arthurfreitas96/PFCII/LFS/Photos/Componentes Removidos da Planta.jpeg

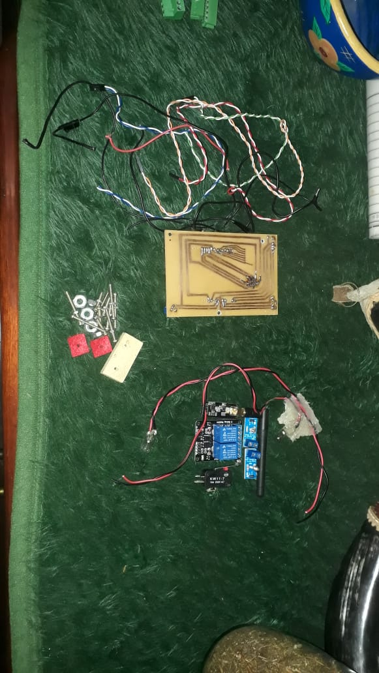
LFS/Photos/Componentes Removidos da Planta.jpeg
