arthurfreitas96/PFCII/LFS/Circuits/HV_Circuit.png

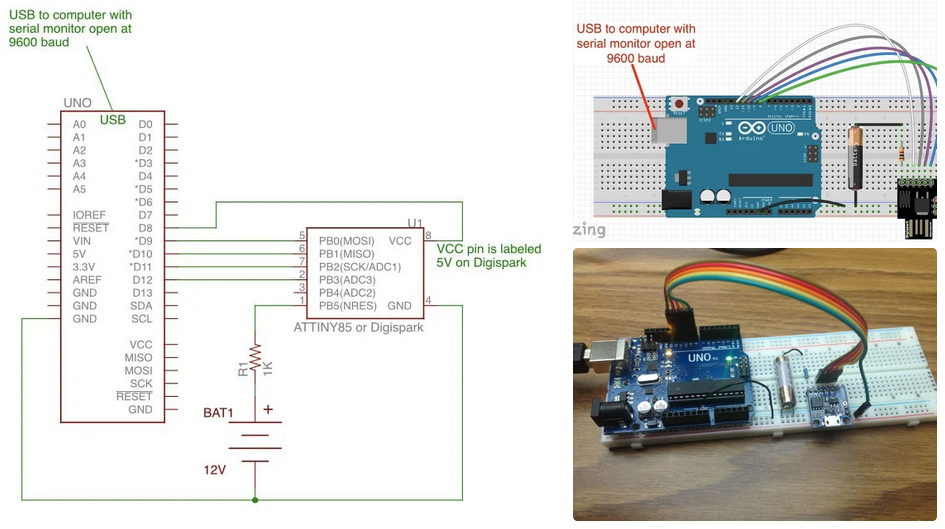
LFS/Circuits/HV_Circuit.png
