arthurfreitas96/PFCII/LFS/Solar_Charts_BH/Carta UofO Hor Padrao.pdf

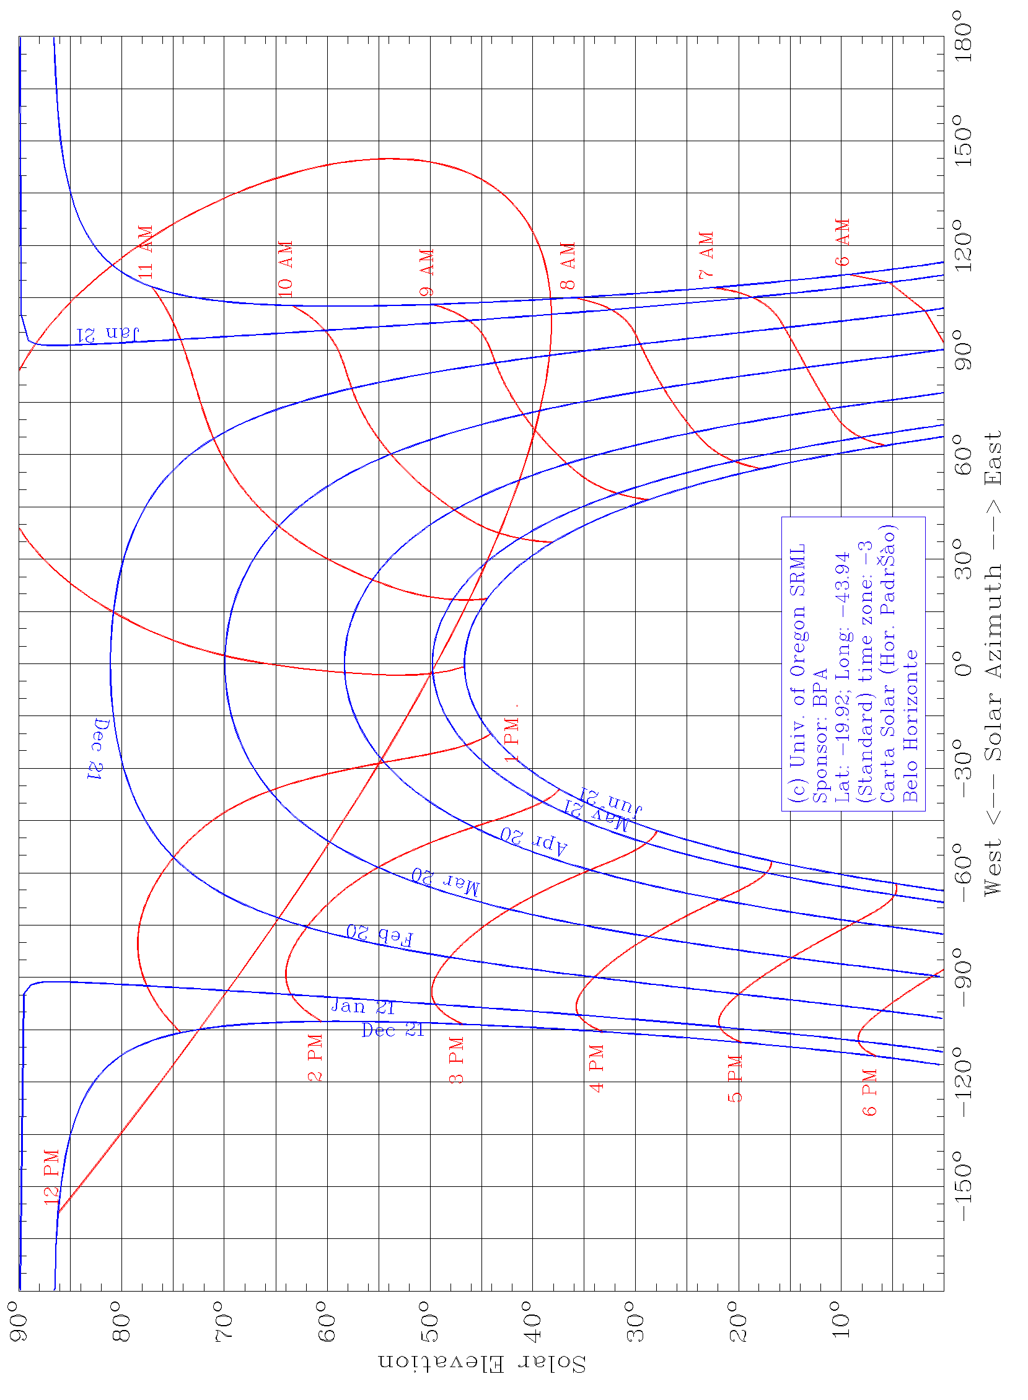
[picture p17: page 1]
