arthurfreitas96/PFCII/LFS/Solar_Charts_BH/Carta UofO.pdf

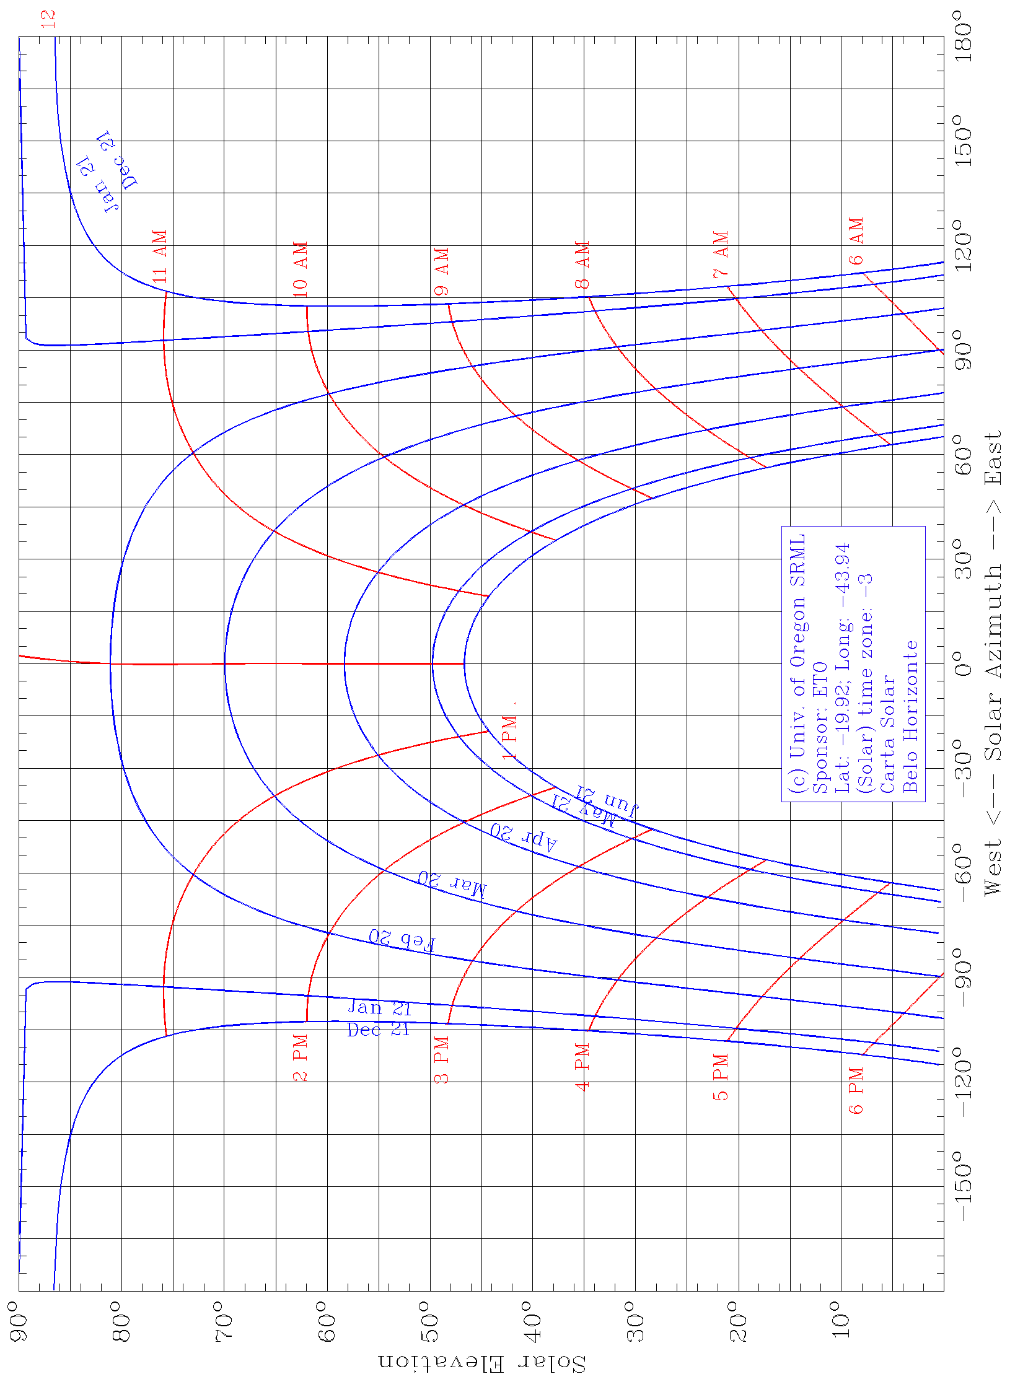
[picture p18: page 1]
