arthurfreitas96/PFCII/LFS/Circuits/Circuito Piranometro_I2C_PB5_IO.png

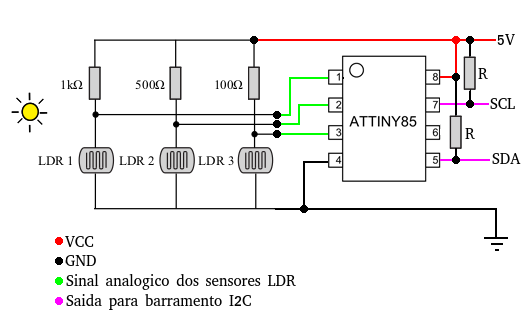
LFS/Circuits/Circuito Piranometro_I2C_PB5_IO.png
