arthurfreitas96/PFCII/LFS/Circuits/CircuitoPotencia.png

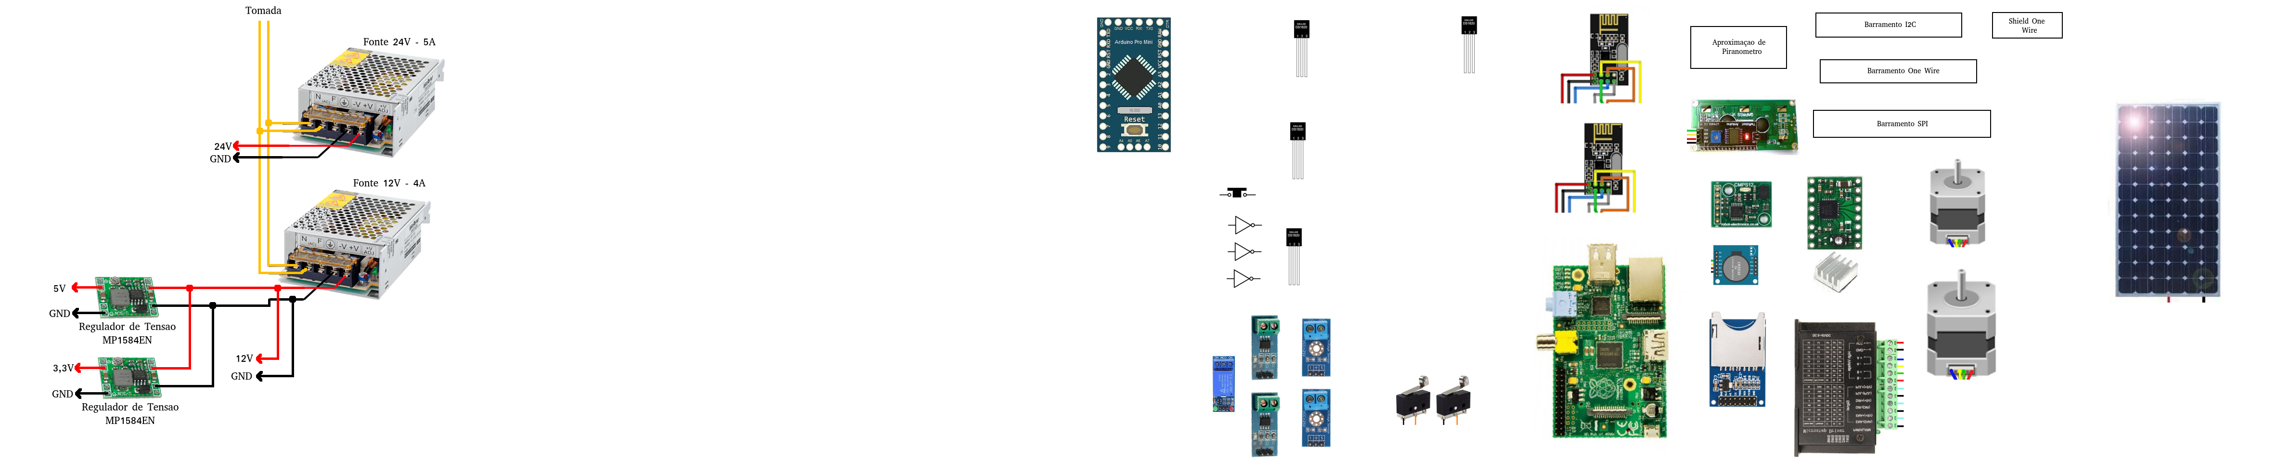
LFS/Circuits/CircuitoPotencia.png
