arthurfreitas96/PFCII/LFS/Circuits/GeracaoEConsumo.png

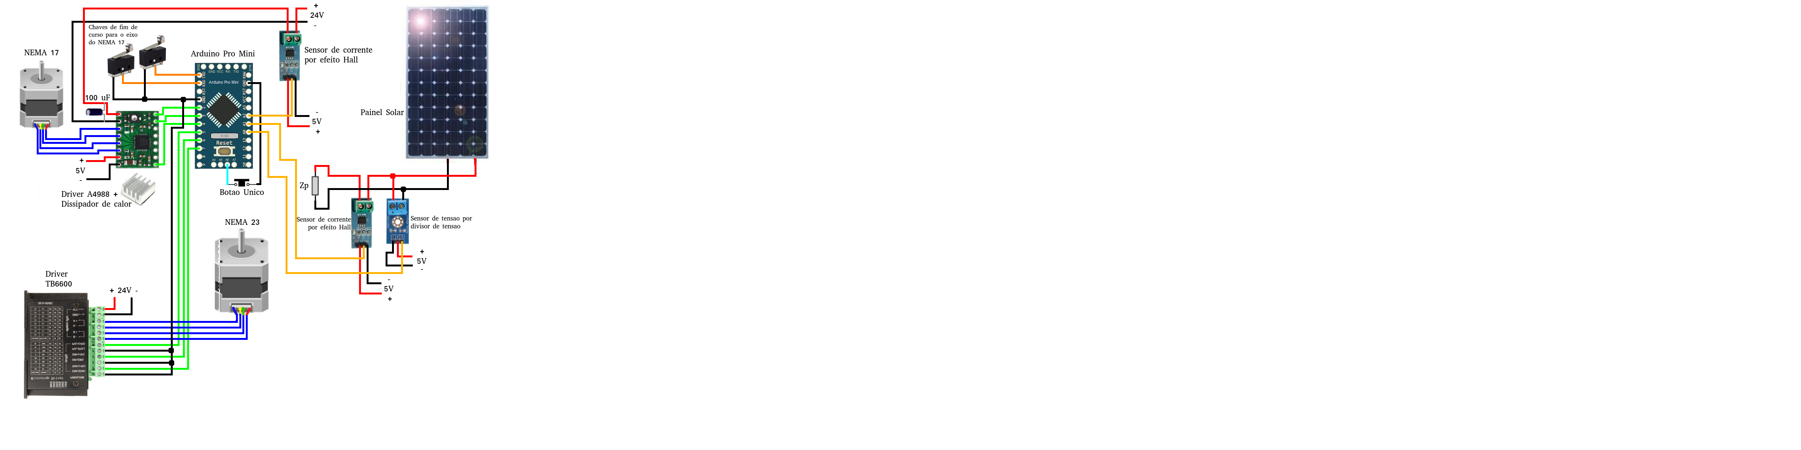
LFS/Circuits/GeracaoEConsumo.png
