arthurfreitas96/PFCII/LFS/Circuits/I2C.png

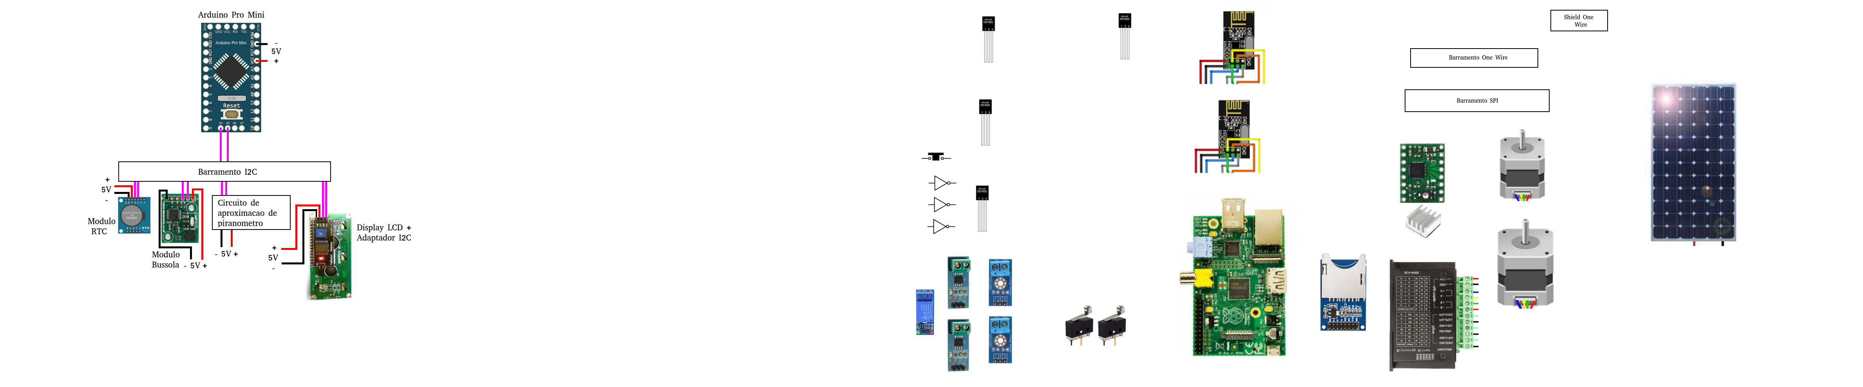
LFS/Circuits/I2C.png
