arthurfreitas96/PFCII/LFS/Circuits/OneWire.png

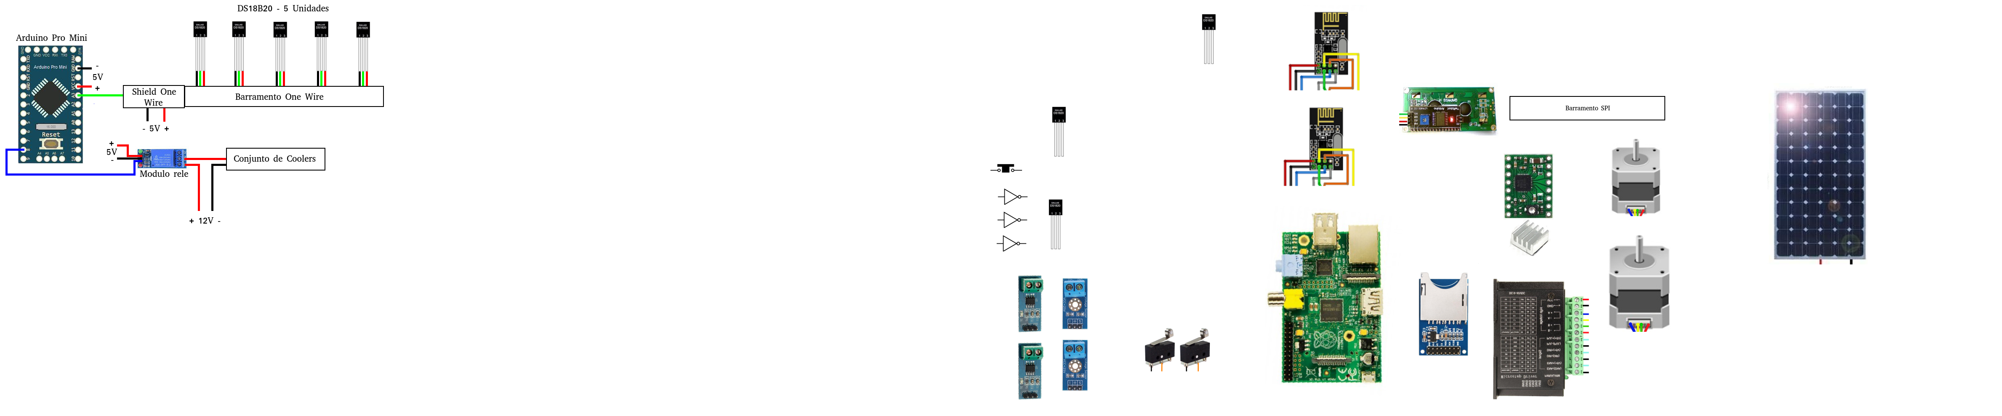
LFS/Circuits/OneWire.png
