arthurfreitas96/PFCII/LFS/Circuits/SPI.png

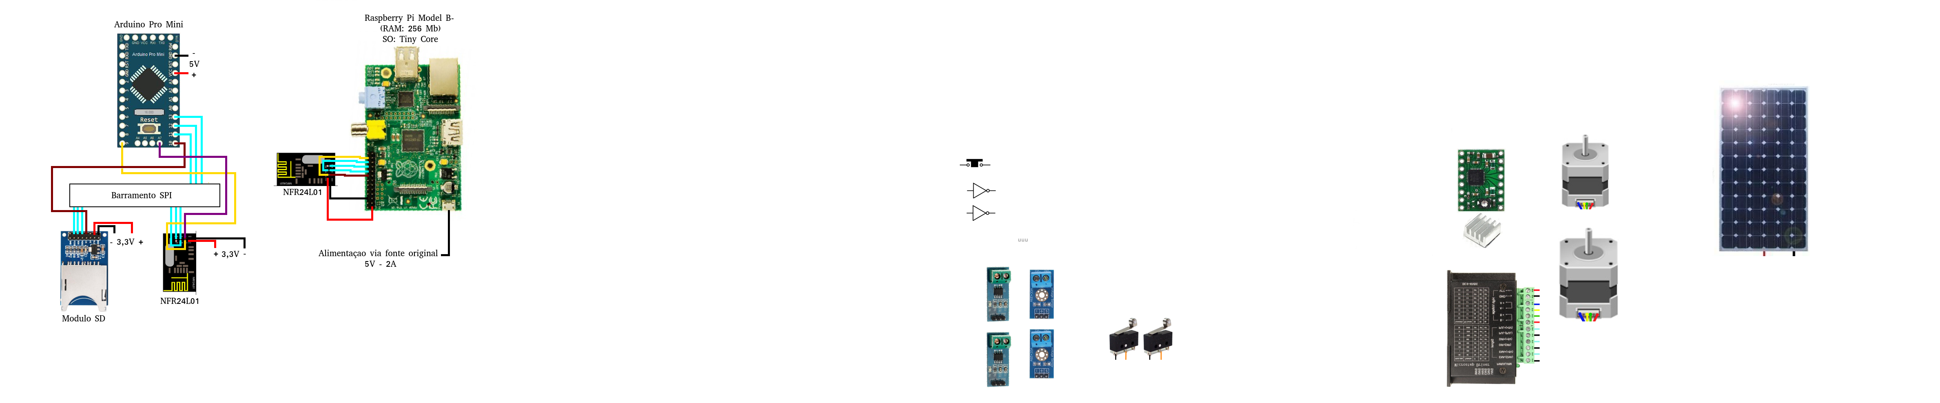
LFS/Circuits/SPI.png
