arthurfreitas96/PFCII/LFS/Photos/CálculoFreqAtuacao.png

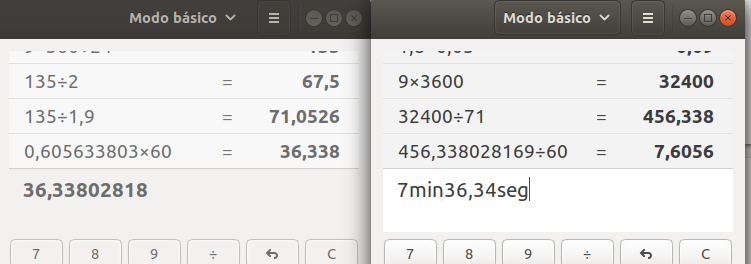
LFS/Photos/CálculoFreqAtuacao.png
