arthurfreitas96/PFCII/LFS/Solar_Charts_BH/carta solar bh.png

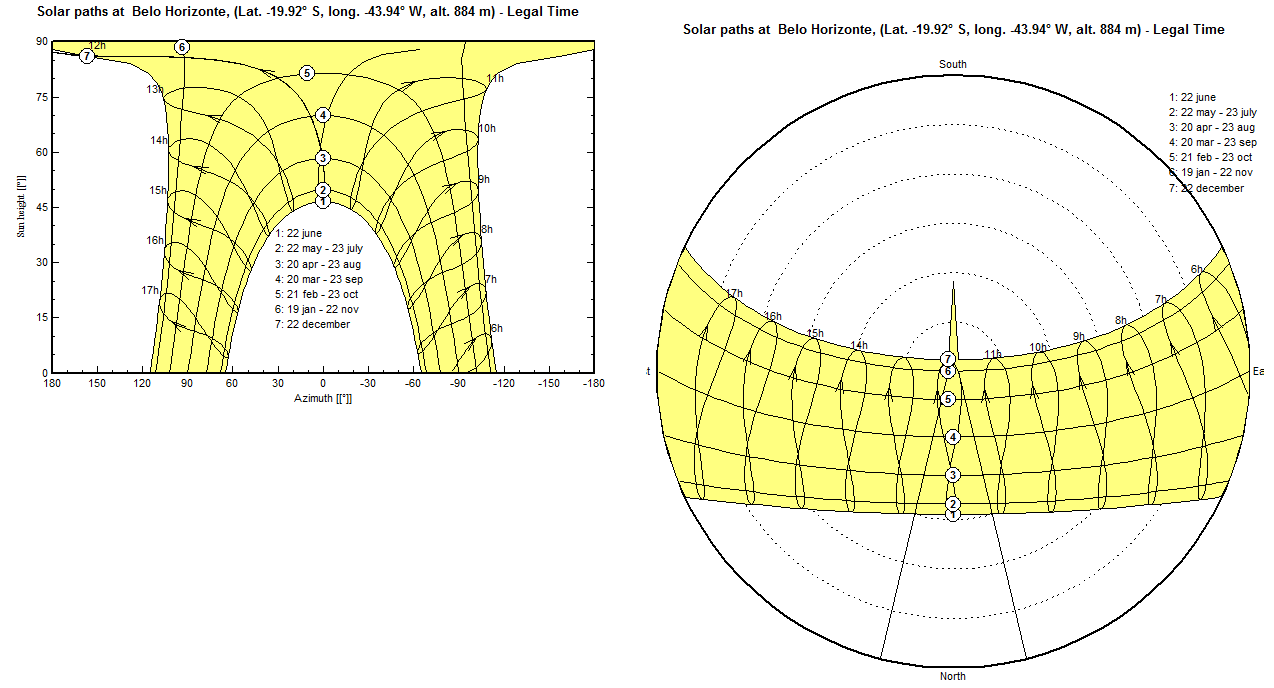
LFS/Solar_Charts_BH/carta solar bh.png
