arthurfreitas96/PFCII/LFS/Circuits/Todos os Componentes.png

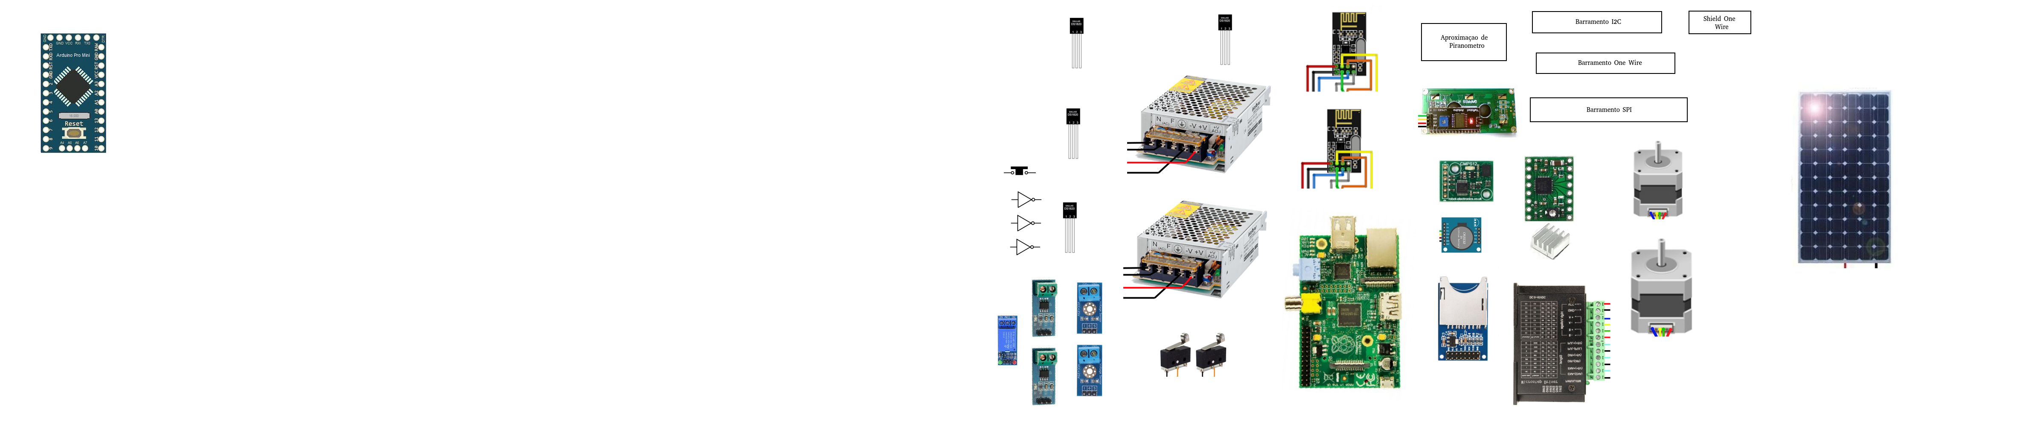
LFS/Circuits/Todos os Componentes.png
