arthurfreitas96/PFCII/Codes_sunchart/Tables/tabelaTeste.ods

Rise | Set
320 | 1117
321 | 1117
322 | 1118
322 | 1118
323 | 1118
324 | 1118
324 | 1119
325 | 1119
326 | 1119
326 | 1119
327 | 1119
328 | 1119
328 | 1119
329 | 1119
330 | 1120
330 | 1120
331 | 1120
332 | 1120
332 | 1119
333 | 1119
334 | 1119
334 | 1119
335 | 1119
335 | 1119
336 | 1119
337 | 1119
337 | 1118
338 | 1118
339 | 1118
339 | 1118
340 | 1117
340 | 1117
341 | 1117
342 | 1116
342 | 1116
343 | 1115
343 | 1115
344 | 1115
344 | 1114
345 | 1114
345 | 1113
346 | 1113
347 | 1112
347 | 1112
348 | 1111
348 | 1110
348 | 1110
349 | 1109
349 | 1109
350 | 1108
350 | 1107
351 | 1107
351 | 1106
352 | 1105
352 | 1105
352 | 1104
353 | 1103
353 | 1102
354 | 1102
354 | 1101
354 | 1100
355 | 1099
355 | 1099
355 | 1098
356 | 1097
356 | 1096
356 | 1095
357 | 1095
357 | 1094
357 | 1093
358 | 1092
358 | 1091
358 | 1090
359 | 1090
359 | 1089
359 | 1088
359 | 1087
360 | 1086
360 | 1085
360 | 1084
361 | 1084
361 | 1083
361 | 1082
361 | 1081
362 | 1080
362 | 1079
362 | 1078
362 | 1077
363 | 1077
363 | 1076
363 | 1075
363 | 1074
364 | 1073
364 | 1072
364 | 1071
365 | 1071
365 | 1070
365 | 1069
365 | 1068
366 | 1067
366 | 1067
366 | 1066
366 | 1065
367 | 1064
367 | 1063
367 | 1063
368 | 1062
368 | 1061
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
