arthurfreitas96/PFCII/(commit log)

2019-12-03 Test code with serial enabled
    Opitmized code to allow reading values from multiple DS18B20 sensors in the same pin using only OneWire.h. I recommend the normal power supply configuration over the parasite type.
2019-12-09 Primeira manipulação de arquivos nos meus estudos de git.
2019-12-09 Wrote notes about the temperature control ino codes.
2019-12-09 Updating the directory to follow the local developing directory.
    [Tabela Nascer Por do Sol BH 2019.ods, tabelaTeste.csv, tabelaTeste.ods]
2019-12-09 Tentando usar o lfs
    [Tabela Nascer Por do Sol BH 2019.ods, tabelaTeste.csv, tabelaTeste.ods]
